ThomasG-29/2026_2C_PF_GenesysRoboticHand_Galindrez-Grassi/Conexionados/conexiones flex y servo.png

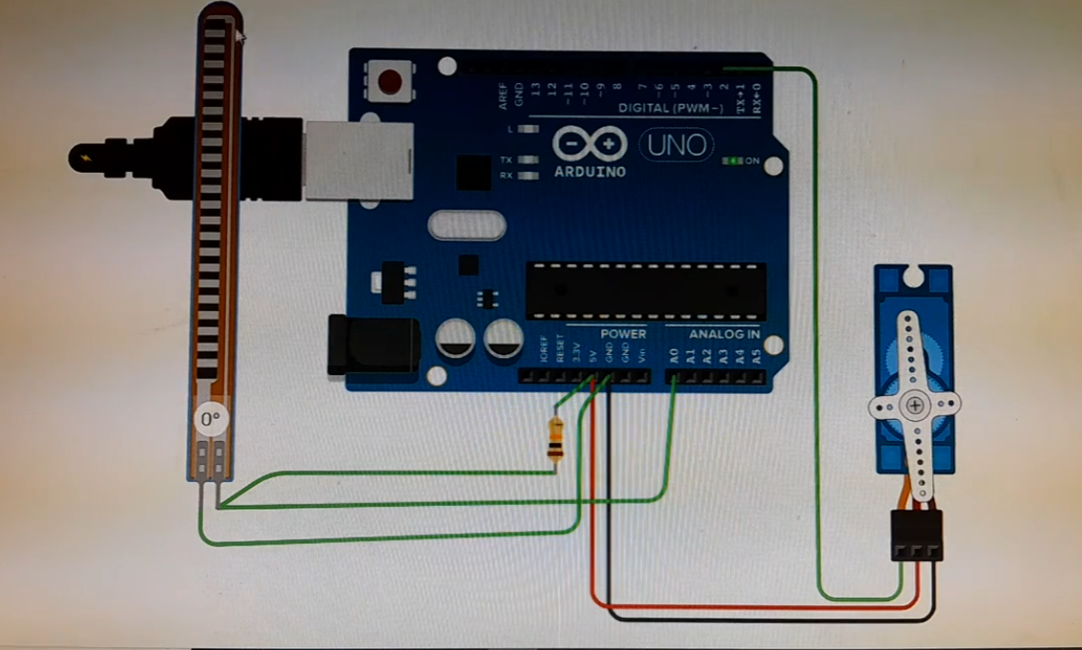
Conexionados/conexiones flex y servo.png
