ThomasG-29/2026_2C_PF_GenesysRoboticHand_Galindrez-Grassi/Documentación/Alcance y objetivos/Gantt Genesys.pdf

## Genesys - Gantt

Nombre | Personas asi… | Fecha límite | Prioridad

Proyectos

Mano humanoide robotica

Propuesta Final y Gantt | MG TG | Hace 3 días
Primera entrega con etapa parcial (por … | | 28/9/26
Segunda entrega incluyendo un porcen… | | 26/10/26
Entrega Proyecto con código fuente en … | | 16/11/26
Lista de materiales provisional | MG T | 16/8/26

Analisis de costos

Plazos de entregas de materiales

Analisis de costos

Plazos de entregas de materiales

Definición del mecanismo | TG | 4/10/26
Mecanismo de apertura y cierre de… | TG | martes
Determinar posición de los actuad… | MG TG | 24/8/26
Mecanismo de movimiento de pulgar | TG | martes
Definir mecanismo de muñeca, rev… | TG | 15/9/26
Definición del mecanismo de eslab… | | 20/9/26
Mecanismo de apertura y cierre de cad… | TG | martes
Impresión de las falanges y prueba… | | martes
Determinar la posición de los actua… | | 15/9/26
Determinar posición de actuadores… | | 15/9/26
Impresión y armado de los act… | | 27/9/26
Mecanismo de movimiento de pulgar | TG | martes
Definir mecanismo de muñeca, revisar … | TG | 15/9/26
Lista de materiales final | MG TG | 2/11/26
Armado de plaqueta con componentes … | MG | 13/9/26
Armado de componentes electrónicos p… | MG | 20/9/26
Pruebas funcionales integracion guante… | MG | 4/10/26
Pruebas funcionales del circuito de… | MG | 4/10/26
Pruebas funcionales del circuito de… | MG | 4/10/26
Calibración de sensores y servos | MG | 4/10/26
Pruebas de comunicación bluetooth/Wi… | MG | 11/10/26
Integración de baterías para el guante … | MG | 25/10/26
Integración componentes electrónicos … | MG TG | 18/10/26
Prueba funcional de la mano robot med… | MG TG | 15/11/26
Pruebas funcionales del circuito de sen… | MG | 4/10/26
Pruebas funcionales del circuito de la … | MG | 4/10/26
Calibración de sensores y servos | MG | 4/10/26
Definición del mecanismo de eslabones… | | 20/9/26
Impresión de las falanges y pruebas de… | | martes
Determinar la posición de los actuadore… | | 15/9/26
Determinar posición de actuadores de … | | 15/9/26
Impresión y armado de los actuado… | | 27/9/26
Impresión y armado de los actuadores … | | 27/9/26
ago. | 2026 | sep. | 2026 | oct. | 2026 | nov. | 2026
3-9 | W32 | 10-16 | W33 | 17-23 | W34 | 24-30 | W35 | 31-6 | W36 | 7-13 | W37 | 14-20 | W38 | 21-27 | W39 | 28-4 | W40 | 5-11 | W41 | 12-18 | W42 | 19-25 | W43 | 26-1 | W44 | 2-8 | W45 | 9-15 | W46 | 16-22 | W47 | 23-29 | W48
MGTG | Propuesta Final y Gantt

Primera entrega con etapa parcial (por ejemplo motores funcionando con driver y versión estable de SW). Con código fuente en Github

Segunda entrega incluyendo un porcentaje superior al 60% de las funcionalidades comprometidas. Con código fuente en Github

Entrega Proyecto con código fuente en Github de la materia

MG T Lista de materiales provisional

TG Definición del mecanismo

TG Mecanismo de apertura y cierre de cada falange

MGTG Determinar posición de los actuadores

TG Mecanismo de movimiento de pulgar

TG Definir mecanismo de muñeca, revisar efector de robots

Definición del mecanismo de eslabones para potenciómetros.

TG Mecanismo de apertura y cierre de cada falange

Impresión de las falanges y pruebas de movimientos

Determinar la posición de los actuadores de A/C

Determinar posición de actuadores de pulgar y mov. lateral

Impresión y armado de los actuadores en la V1 del antebrazo.

TG Mecanismo de movimiento de pulgar

TG Definir mecanismo de muñeca, revisar efector de robots

MGTG Lista de materiales final

MG Armado de plaqueta con componentes electronicos para el guante

MG Armado de componentes electrónicos para el brazo robot

MG Pruebas funcionales integracion guante y mecanismo

MG Pruebas funcionales del circuito de sensores del guante

MG Pruebas funcionales del circuito de la mano robot

MG Calibración de sensores y servos

MG Pruebas de comunicación bluetooth/WiFi entre microcontroladores

MG Integración de baterías para el guante y el prototipo robótico

MGTG Integración componentes electrónicos en el mecanismo

MG Pruebas funcionales del circuito de sensores del guante

MG Pruebas funcionales del circuito de la mano robot

MG Calibración de sensores y servos

Definición del mecanismo de eslabones para potenciómetros.

Impresión de las falanges y pruebas de movimientos

Determinar la posición de los actuadores de A/C

Determinar posición de actuadores de pulgar y mov. lateral

Impresión y armado de los actuadores en la V1 del antebrazo.

Impresión y armado de los actuadores en la V1 del antebrazo.
