ThomasG-29/2026_2C_PF_GenesysRoboticHand_Galindrez-Grassi/Conexionados/Circuito_guante - v2_bb.jpg

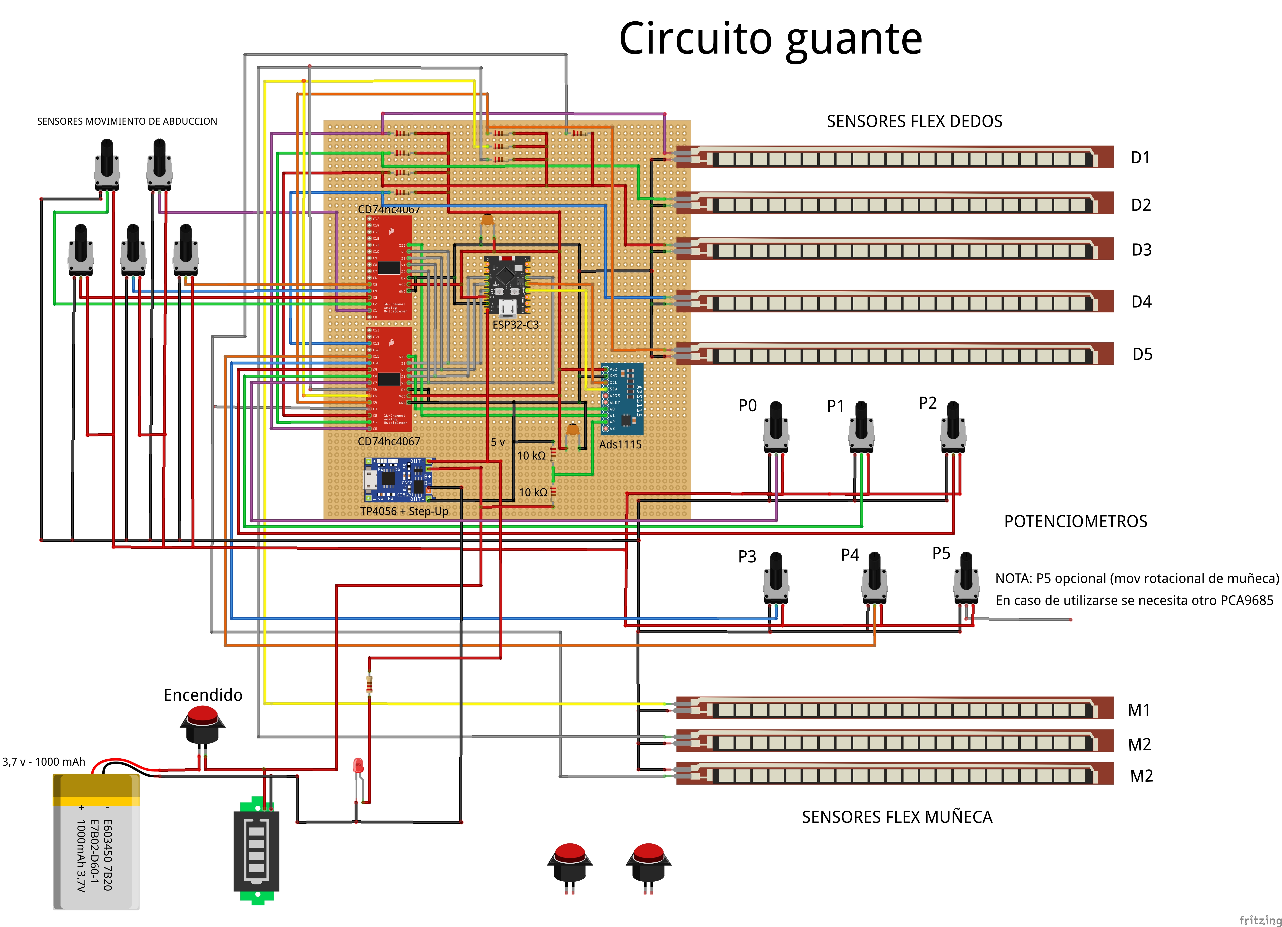
Conexionados/Circuito_guante - v2_bb.jpg
