ThomasG-29/2026_2C_PF_GenesysRoboticHand_Galindrez-Grassi/Conexionados/Circuito_guante_bb.png

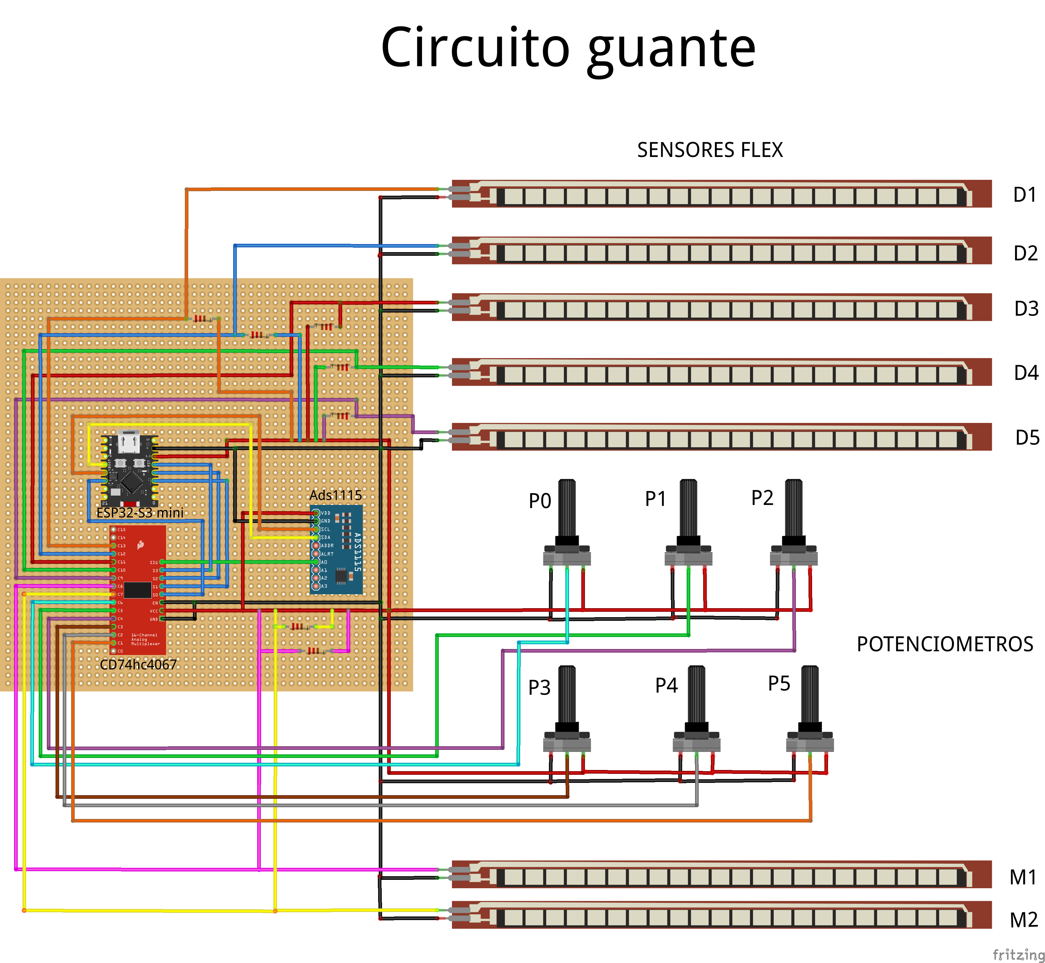
Conexionados/Circuito_guante_bb.png
