ThomasG-29/2026_2C_PF_GenesysRoboticHand_Galindrez-Grassi/Conexionados/Circuito_mano_robot_bb.jpg

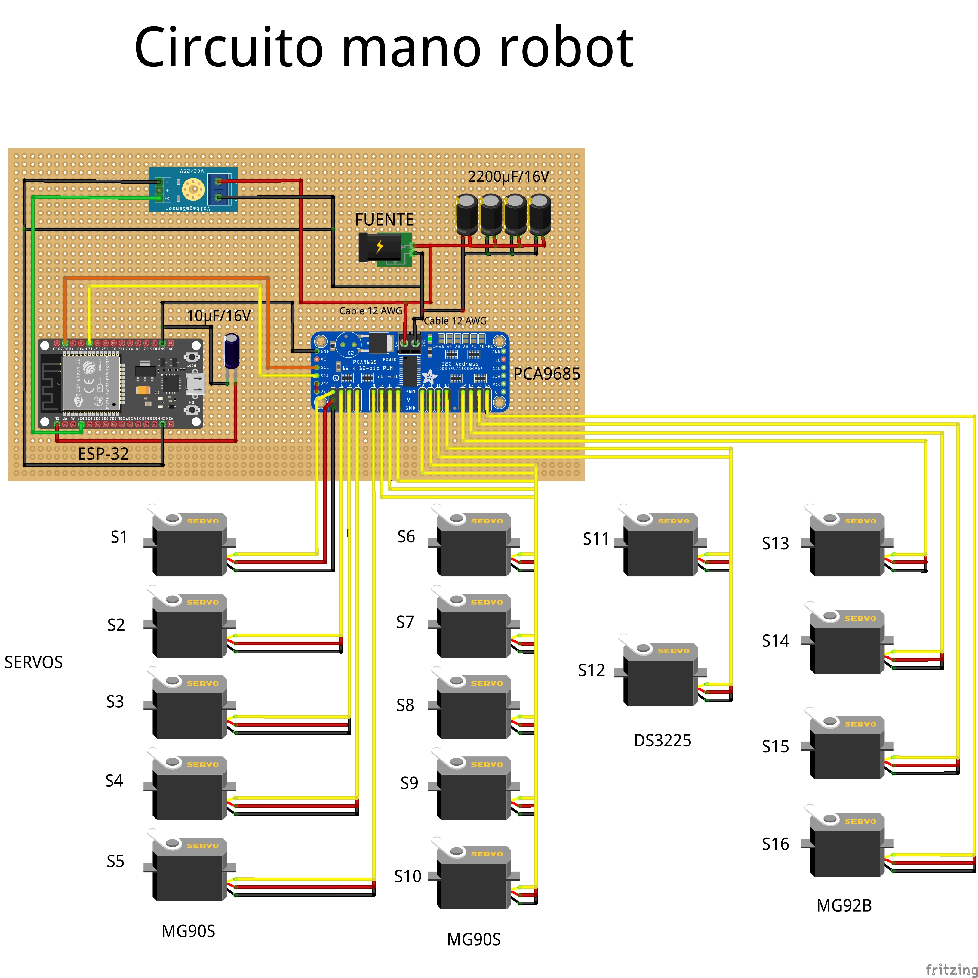
Conexionados/Circuito_mano_robot_bb.jpg
