ThomasG-29/2026_2C_PF_GenesysRoboticHand_Galindrez-Grassi/Documentación/Lista de materiales.xlsx

Sheet: Lista de materiales
LISTA DE MATERIALES
Item | Cantidad | Marca | modelo | Material | peso (gr) | Dimensiones (mm) | Precio unit(ARS) | Precio total | Total Dolares | Plazo de entrega (días) | Proveedor
Servomotor dedos | 10 | Towerpro | Mini Servo Mg90s | Plastico y metal | 16.5 | 31 x 11 x 31 | $8728.00 | $87280.00 | $58.19 | 2.00 | https://www.mercadolibre.com.ar/mini-servo-mg90s-18kg-torque-desarrollo-domotica/up/MLAU132173611
Servomotor muñeca y base (x2) | 1 | Generico | Dsservo Ds3225 | Plastico y metal | 67 | 40 x 20 x 40,5 | $58407.00 | $58407.00 | $38.94 | 15.00 | https://www.mercadolibre.com.ar/servo-digital-dsservo-ds3225-para-coche-25-kg-metal-gear-h/p/MLA2059431731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
Servomotor dedos abducción | 4 | Towerpro | Servo Mg92B | Plastico y metal | 13.8 | 22,8 x 12 x 31 | $22294.00 | $89176.00 | $59.45 | 4.00 | https://www.mercadolibre.com.ar/mini-servo-tower-pro-mg92b-metal-14gr-alto-torque-35kg/up/MLAU267010549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
Sensores flex (x 5) | 2 |  | Generico | ABS | 18 | 80 x 50 x 50 | $65958.00 | $131916.00 | $87.94 | 15.00 | https://www.mercadolibre.com.ar/sensor-de-flexion-5x-de-22-pulgadas-para-manipulador-electr/p/MLA2073926990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
Guante x2 | 1 | Generico | Generico | goma | 2 |  | $2000.00 | $2000.00 | $1.33 | Inmediato | Easy
Bobina De Hilo Multifilamento 8x Rojo 500 Mts | 1 | Colours | Generico | Nylon | 12 | 500 m | $40565.00 | $40565.00 | $27.04 | 2.00 | https://articulo.mercadolibre.com.ar/MLA-3337449752-bobina-de-hilo-multifilamento-8x-rojo-500-mts-035mm445kg-rojo-_JM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
Microcontrolador mano | 1 |  | ESP32 | PCB | 10 | 28 x 55 x 12 | $15990.00 | $15990.00 | $10.66 | 2.00 | https://www.mercadolibre.com.ar/nodemcu-esp32-38-pines-usb-c-wifi-bluetooth-placa-desarrollo-iot-compatible-arduino/p/MLA42485623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
Microcontrolador guante | 1 |  | ESP32-C3 SuperMini | PCB | 2 | 22,7 x 18 x 11 | $6929.00 | $6929.00 | $4.62 | 2.00 | https://www.mercadolibre.com.ar/nodemcu-esp32-c3-supermini-wifi-bluetooth-50-usb-c-iot-16-pines-compatible-arduino/p/MLA61634225
Controlador de servos | 1 |  | PCA9685 | PCB | 9 | 62,5 x 25,4 x 12 | $9900.00 | $9900.00 | $6.60 | 2.00 | https://www.mercadolibre.com.ar/controlador-servos-16-canales-i2c-pca9685-pwm-arduino-candy/up/MLAU270638199
Batería LiPo | 1 | Li-Poly | Generico | Litio | 16 | 43 x 25 x 9 | $16923.00 | $16923.00 | $11.28 | 2.00 | https://www.mercadolibre.com.ar/bateria-lipo-con-cable-jst-ph-37v-500mah/p/MLA2098680796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
Multiplexor 74hc4067 | 2 | OEM | CD74hc4067 | PCB | 2 | 18 x 41 | $6000.00 | $12000.00 | $8.00 | 2.00 | https://www.mercadolibre.com.ar/multiplexor-analogico-16-canales-74hc4067/up/MLAU397549426
Potenciometro Rv09 Horizontal Eje 6x12.5mm 10k Lineal | 10 | Elumiled | Rv09 | Metal | 5 | 12,5 x 9,7 | $4589.00 | $45890.00 | $30.59 | 2.00 | https://www.mercadolibre.com.ar/potenciometro-rv09-horizontal-eje-6x125mm-10k-lineal/up/MLAU3414529553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
Rollo de cables | 1 | Dupont | Varios | Cobre y pvc | 10 | 1 m de largo | $15890.00 | $15890.00 | $10.59 | 2.00 | https://articulo.mercadolibre.com.ar/MLA-1741277541-cable-plano-40-conductores-dupont-254mm-por-1-metro-_JM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
Tornillos y tuercas | 50 | Varios |  |  |  |  |  | $20000.00 | $13.33 | 2.00
Filamentos para estructura | 3 | Print a Lot/ Grilon / bambulab |  |  | 3000 |  | $30000.00 | $90000.00 | $60.00 | 2.00
Fuente alimentación 5v 20a 100w | 1 | Vapex | FM-5-20A | Metal | 500 | 60 x 180 x 200 | $33309.00 | $33309.00 | $22.21 | 2.00 | https://www.mercadolibre.com.ar/fuente-metalica-5v-20a-100w-vapex/p/MLA68261036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
Rodamientos MR106 zz | 45 |  | MR 106 |  | 45 | 6x10x3 | $2160.15 | $97206.75 | $64.80 | 2.00 | https://www.mercadolibre.com.ar/ruleman-mr-106-zz-6x10x3-x40-unidades-ms-rodamientos/up/MLAU258016962
Cargador Bateria Litio Tp4056 | 1 | INFORMATICA SAN ISIDRO | Tp4056 | PCB | 1 | 10 x 23,5 x 33 | $4990.00 | $4990.00 | $3.33 | 2.00 | https://www.mercadolibre.com.ar/cargador-bateria-litio-tp4056-1a-con-fuente-boost-step-up-2a/up/MLAU2907940508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
Modulo Indicador Carga De Bateria De Litio | 1 | Candy-Ho | Generico | Plastico | 1 | 45 x 20 x 8 | $7086.00 | $7086.00 | $4.72 | 2.00 | https://www.mercadolibre.com.ar/modulo-indicador-carga-de-bateria-de-litio-3s-111v--126v/up/MLAU309927320
Capacitor cerámico | 3 |  | Generico | ceramico | 1 |  | $300.00 | $900.00 | $0.60 | inmediato | Full electronica
Capacitor electrolitico x20 | 1 | Candy-Ho | Generico |  | 1 | 0,2 x 0,13 | $12134.00 | $12134.00 | $8.09 | 2.00 | https://www.mercadolibre.com.ar/pack-x20-capacitor-electrolitico-2200uf-16v-low-esr-10x20mm/up/MLAU4564573641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
Diodo Schottky | 1 |  | Generico |  | 1 |  | $300.00 | $300.00 | $0.20 | inmediato | Full electronica
Placa experimental | 1 | ELEPRINT | PE-44 | PCB | 5 | 15 x 10 | $12400.00 | $12400.00 | $8.27 | 2.00 | Full electronica
Resistencias x50 | 1 |  |  |  |  |  | $3990.00 | $3990.00 | $2.66 | 2.00 | https://articulo.mercadolibre.com.ar/MLA-1484686813-pack-50-resistencias-1-14w-metal-film-1-a-91-kohm-elegir-_JM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
Conversor Ads1115 | 1 | Generico | Ads1115 | PCB | 5 | 30 x 18 x 3 | $7999.00 | $7999.00 | $5.33 | 2.00 | https://www.mercadolibre.com.ar/ads1115-adc-16-bit-conversor-ad-4-canales-arduino/p/MLA2038776439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
Modulo Sensor De Tension | 1 | INFORMATICA SAN ISIDRO | Modulo Sensor de Tension Voltaje 0v-25v Dc Arduino | PCB | 2 | 20 x 10 x 10 | $3789.00 | $3789.00 | $2.53 | 2.00 | https://www.mercadolibre.com.ar/modulo-sensor-de-tension-voltaje-0v25v-dc-arduino/up/MLAU292830096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
Pack X3 Boton Pulsador Switch Sin Retencion | 1 | INFORMATICA SAN ISIDRO | Generico | plastico | 3 | 10 x 25,5 | $7215.00 | $7215.00 | $4.81 | 2.00 | https://www.mercadolibre.com.ar/pack-x3-boton-pulsador-switch-sin-retencion-2-pines-10mm/up/MLAU3597061591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
Pack X3 Boton Pulsador Switch Retencion | 1 | INFORMATICA SAN ISIDRO | Generico | plastico | 3 | 13 x 19,5 | $8763.00 | $8763.00 | $5.84 | 2.00 | https://www.mercadolibre.com.ar/pack-x3-boton-pulsador-switch-retencion-selflock-10mm-rojo/up/MLAU3644919741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
Leds genericos | 1 | Generico | Generico | plastico | 1 | 8 x 30 x 5 | $9364.00 | $9364.00 | $6.24 | 1.00 | https://www.mercadolibre.com.ar/pack-30-leds-5mm-rojo-amarillo-verde-arduino-nubbeo-variados/p/MLA78714347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|item_id:MLA3896689262#is_advertising=true&searchVariation=MLA78714347&backend_model=search-backend&be_origin=searchv2&position=4&search_layout=grid&type=pad&tracking_id=93dc18bf-5e5c-4c39-8b38-4017776e893c&ad_domain=VQCATCORE_LST&ad_position=4&ad_click_id=OGVmNTNlMmUtMWIzZS00ODg2LTlkMjYtYTdhMzIyNzc2YjYw
Total |  |  |  |  | 3752.3 |  |  | $852311.75 | $568.21 |  | 27

Sheet: Herramientas
Herramientas
Impresora 3D
Soldador
Multímetro
Destornillador
Cinta aisladora
Fuente alimentacion
Pinza
Alicate
Pegamento
