ThomasG-29/2026_2C_PF_GenesysRoboticHand_Galindrez-Grassi/Documentación/Diagrama_Gantt-Mano_humanoide_robotica.xlsx

Sheet: Gantt
Proyecto Genesys - Mano humanoide robótica
Diagrama de Gantt · Proyecto final de Ingeniería Mecatrónica |  |  |  | Inicio del proyecto | 2026-08-10
Equipo: Mayra Grassi (M) · Thomas Agustín Galindrez (T) |  |  |  | Desplazar vista (días) | 0
53 tareas y subtareas | 35 completadas |  | 11 en curso |  | 7 pendientes |  | 174 h registradas |  | 2026-08-10 |  |  |  |  |  |  | 2026-08-17 |  |  |  |  |  |  | 2026-08-24 |  |  |  |  |  |  | 2026-08-31 |  |  |  |  |  |  | 2026-09-07 |  |  |  |  |  |  | 2026-09-14 |  |  |  |  |  |  | 2026-09-21 |  |  |  |  |  |  | 2026-09-28
 |  |  |  |  |  |  |  |  | 2026-08-10 | 2026-08-11 | 2026-08-12 | 2026-08-13 | 2026-08-14 | 2026-08-15 | 2026-08-16 | 2026-08-17 | 2026-08-18 | 2026-08-19 | 2026-08-20 | 2026-08-21 | 2026-08-22 | 2026-08-23 | 2026-08-24 | 2026-08-25 | 2026-08-26 | 2026-08-27 | 2026-08-28 | 2026-08-29 | 2026-08-30 | 2026-08-31 | 2026-09-01 | 2026-09-02 | 2026-09-03 | 2026-09-04 | 2026-09-05 | 2026-09-06 | 2026-09-07 | 2026-09-08 | 2026-09-09 | 2026-09-10 | 2026-09-11 | 2026-09-12 | 2026-09-13 | 2026-09-14 | 2026-09-15 | 2026-09-16 | 2026-09-17 | 2026-09-18 | 2026-09-19 | 2026-09-20 | 2026-09-21 | 2026-09-22 | 2026-09-23 | 2026-09-24 | 2026-09-25 | 2026-09-26 | 2026-09-27 | 2026-09-28
Tarea | Resp. | Estado | Progreso | Inicio | Fin | Horas est. | Horas reales | Observaciones | L | M | X | J | V | S | D | L | M | X | J | V | S | D | L | M | X | J | V | S | D | L | M | X | J | V | S | D | L | M | X | J | V | S | D | L | M | X | J | V | S | D | L | M | X | J | V | S | D | L
GESTIÓN, DOCUMENTACIÓN Y ENTREGAS
Lista de materiales provisional | M/T | ● Completada | 100% | 2026-08-11 | 2026-08-16 |  | 1.0 | Cerrada el 08/09 · asignada a usuario fuera del espacio
Analisis de costos | — | ● Completada | 100% | 2026-08-11 | 2026-09-08 |  |  | Cerrada el 08/09 · fechas = creación/cierre · sin responsable
Plazos de entregas de materiales | — | ● Completada | 100% | 2026-08-11 | 2026-09-08 |  |  | Cerrada el 08/09 · fechas = creación/cierre · sin responsable
Propuesta Inicial | M/T | ● Completada | 100% | 2026-08-13 | 2026-08-24 |  |  | Cerrada el 25/08 · inicio = 1.ª subtarea
Definición del alcance | M/T | ● Completada | 100% | 2026-08-13 | 2026-08-13 |  |  | Cerrada el 25/08 · sin inicio en ClickUp
Creación de Github y publicación de la primera versión con el alcance preeliminar | T | ● Completada | 100% | 2026-08-24 | 2026-08-24 |  | 1.5 | Cerrada el 25/08 · sin inicio en ClickUp
Propuesta Final y Gantt | M/T | ● Completada | 100% | 2026-09-03 | 2026-09-03 |  |  | Cerrada el 08/09 · sin inicio en ClickUp
Primera entrega con etapa parcial (por ejemplo motores funcionando con driver y versión estable de SW). Con código fuente en Github | M/T | ● Completada | 100% | 2026-09-28 | 2026-09-28 |  |  | Cerrada el 29/09 · sin inicio en ClickUp
Segunda entrega incluyendo un porcentaje superior al 60% de las funcionalidades comprometidas. Con código fuente en Github | M/T | ● Completada | 100% | 2026-10-26 | 2026-10-26 |  |  | Cerrada el 09/11 · sin inicio en ClickUp
Lista de materiales final | M/T | ● Completada | 100% | 2026-11-02 | 2026-11-02 |  | 2.6 | Cerrada el 06/10 · sin inicio en ClickUp
Entrega Proyecto con código fuente en Github de la materia | M/T | ● Pendiente | 0% | 2026-11-16 | 2026-11-16 |  |  | Sin inicio en ClickUp
DISEÑO MECÁNICO
Escaneo mano de colo | Otro | ● Completada | 100% | 2026-08-11 | 2026-08-15 |  | 2.0 | Cerrada el 18/08 · asignada a usuario fuera del espacio
Definición del mecanismo | T | ● En curso | 40% | 2026-08-13 | 2026-10-04 |  | 28.1
Mecanismo de apertura y cierre de cada falange | T | ● En curso | 0% | 2026-08-13 | 2026-09-08 |  | 31.5
Impresión de las falanges y pruebas de movimientos | — | ● Pendiente | 0% | 2026-08-31 | 2026-09-08 |  |  | Sin responsable
Determinar la posición de los actuadores de A/C | — | ● Pendiente | 0% | 2026-08-31 | 2026-09-15 |  |  | Sin responsable
Determinar posición de actuadores de pulgar y mov. lateral | — | ● Pendiente | 0% | 2026-08-31 | 2026-09-15 |  |  | Sin responsable
Impresión y armado de los actuadores en la V1 del antebrazo. | — | ● Pendiente | 0% | 2026-09-14 | 2026-09-27 |  |  | Sin responsable
Determinar posición de los actuadores | M/T | ● Completada | 100% | 2026-08-24 | 2026-08-24 |  | 2.0 | Cerrada el 25/08 · sin inicio en ClickUp
Definir mecanismo de muñeca, revisar efector de robots | T | ● En curso | 50% | 2026-08-31 | 2026-09-15
Mecanismo de movimiento de pulgar | T | ● En curso | 50% | 2026-09-08 | 2026-09-08 |  |  | Sin inicio en ClickUp
Definición del mecanismo de eslabones para potenciómetros. | — | ● Pendiente | 0% | 2026-09-20 | 2026-09-20 |  |  | Sin inicio en ClickUp · sin responsable
Preparaciones - Calibraciones de impresoras 3D y maquinas de fabricación. | T | ● En curso | 50% | 2026-10-12 |  |  | 3.5 | Inicio = creación · sin fecha de fin
DESARROLLO ELECTRÓNICO Y GUANTE
Pruebas de electrónica | M | ● Completada | 100% | 2026-08-26 | 2026-08-27 |  |  | Cerrada el 26/08 · inicio = 1.ª subtarea · fin = última subtarea
Controlar servomotores mediante código. | M | ● Completada | 100% | 2026-08-26 | 2026-08-26 |  | 0.6 | Cerrada el 26/08 · sin inicio en ClickUp
Leer los valores analógicos de los sensores flex | M | ● Completada | 100% | 2026-08-26 | 2026-08-26 |  | 0.6 | Cerrada el 26/08 · sin inicio en ClickUp
Controlar servomotores mediante flex posicionados en un guante y calibrar movimientos | M | ● Completada | 100% | 2026-08-27 | 2026-08-27 |  | 0.7 | Cerrada el 26/08 · sin inicio en ClickUp
Determinación sensores extras para GDL de muñeca | M | ● Completada | 100% | 2026-08-28 | 2026-08-29 |  | 1.0 | Cerrada el 30/08
Armado de diagramas de conexionados | M | ● Completada | 100% | 2026-08-29 | 2026-09-20 |  | 7.4 | Cerrada el 12/10
Armado de plaqueta con componentes electronicos para el guante | M | ● Completada | 100% | 2026-08-31 | 2026-09-13 |  |  | Cerrada el 06/10
Armado y pruebas en protoboard | M | ● Completada | 100% | 2026-08-31 | 2026-09-06 |  | 8.3 | Cerrada el 08/09
Armado de componentes en plaqueta | M | ● Completada | 100% | 2026-09-06 | 2026-09-11 |  | 1.2 | Cerrada el 09/09
Soldadura en plaqueta PCB | M | ● Completada | 100% | 2026-09-06 | 2026-09-11 |  | 21.3 | Cerrada el 06/10
Pruebas con componentes soldados en la PCB | M | ● Completada | 100% | 2026-09-11 | 2026-09-13 |  | 5.4 | Cerrada el 06/10
Armado de componentes electrónicos para el brazo robot | M | ● Completada | 100% | 2026-09-14 | 2026-09-20 |  | 0.5 | Cerrada el 27/09
Armado y pruebas en protoboard | M | ● Completada | 100% | 2026-09-14 | 2026-09-18 |  | 3.5 | Cerrada el 27/09
Soldado de componentes | M | ● Completada | 100% | 2026-09-14 | 2026-09-18 |  | 2.3 | Cerrada el 12/10
Pruebas funcionales | M | ● Completada | 100% | 2026-09-18 | 2026-09-20 |  | 3.0 | Cerrada el 27/09
Diseño del guante: implementación de sensores, cables y accesorios | M | ● En curso | 83.33333333% | 2026-10-12 | 2026-10-25 | 20.0 | 13.4
Pruebas funcionales y ajuste de sensores | M | ● Completada | 100% | 2026-10-12 | 2026-10-18 |  | 1.9 | Cerrada el 25/10
Implementación de mecanismo para potenciometros | M | ● Completada | 100% | 2026-10-19 | 2026-10-25 |  | 4.7 | Cerrada el 24/10
Carcasa para el guante | M | ● En curso | 50% | 2026-10-27 | 2026-11-01 |  | 6.5
Integración de baterías para el guante | M | ● Completada | 100% | 2026-11-09 | 2026-11-15 |  | 4.3 | Cerrada el 09/11
INTEGRACIÓN Y PRUEBAS
Pruebas funcionales inalambricas - integración guante y mecanismo | M | ● Completada | 100% | 2026-09-21 | 2026-10-11 |  |  | Cerrada el 12/10
Pruebas de comunicación bluetooth/WiFi/ESP-NOW entre microcontroladores | M | ● Completada | 100% | 2026-09-21 | 2026-09-24 |  | 9.7 | Cerrada el 12/10
Pruebas funcionales de comunicación entre los sensores y servos | M | ● Completada | 100% | 2026-09-25 | 2026-09-30 |  | 1.2 | Cerrada el 12/10
Calibración de sensores y servos | M | ● Completada | 100% | 2026-10-01 | 2026-10-04 |  | 0.8 | Cerrada el 12/10
Seteo de servomotores en cero | M | ● Completada | 100% | 2026-10-12 | 2026-10-12 |  | 0.6 | Cerrada el 12/10 · fechas = creación/cierre
Integración componentes electrónicos en el mecanismo | M/T | ● En curso | 50% | 2026-10-19 | 2026-10-25 |  | 1.7
Prueba funcional de la mano robot mediante el guante | M/T | ● En curso | 33.33333333% | 2026-10-26 | 2026-11-15 |  | 0.7
Agregado de condiciones de seguridad, home y demás | M | ● En curso | 50% | 2026-10-26 | 2026-11-15 | 1.0 | 0.4
Ajustes mecánicos, electrónicos y físicos | M/T | ● Pendiente | 0% | 2026-10-26 | 2026-11-15
Calibracion de sensores con la mano | M/T | ● En curso | 50% | 2026-10-26 | 2026-11-15 | 3.0
Fechas importantes
Propuesta inicial | 2026-08-24 |  | ● Completada
Propuesta final y Gantt | 2026-09-03 |  | ● Completada
Primera entrega: etapa parcial (motores con driver y versión estable de SW) + código en GitHub | 2026-09-28 |  | ● Completada
Segunda entrega: más del 60% de las funcionalidades comprometidas + código en GitHub | 2026-10-26 |  | ● Completada
Entrega final del proyecto con código fuente en GitHub | 2026-11-16 |  | ● Pendiente
Resumen de horas
Horas estimadas (ClickUp) | 24.0 h
Horas reales (tiempo registrado + carga manual) | 173.9 h
Referencias
Duración planificada (inicio → fin)
Parte completada según el % de progreso
Día de hoy
Valores editables o cargados a mano (azul) | 123
Progreso de tareas con subtareas = promedio de sus subtareas
Horas reales = tiempo registrado en esa tarea, sin sumar subtareas; verde si no supera lo estimado, rojo si lo supera
Fuente: ClickUp, espacio «Mano humanoide robótica». Datos exportados el 10/11/2026 (incluye 160 registros de tiempo).

Sheet: Datos ClickUp
ID | Tarea | Tarea padre | Nivel | Estado | Responsables | Inicio (ClickUp) | Vencimiento (ClickUp) | Creada | Cerrada | Estimado (h) | Tiempo registrado (h) | Link
86e2ry5t9 | Lista de materiales provisional |  | 0 | ● Completada | Usuario fuera del espacio (101307576), Mayra Grassi | 2026-08-11 | 2026-08-16 | 2026-08-11 | 2026-09-08 |  | 1.00 | https://app.clickup.com/t/86e2ry5t9
86e2ry5yx | Analisis de costos | Lista de materiales provisional | 1 | ● Completada |  |  |  | 2026-08-11 | 2026-09-08 |  |  | https://app.clickup.com/t/86e2ry5yx
86e2ry61p | Plazos de entregas de materiales | Lista de materiales provisional | 1 | ● Completada |  |  |  | 2026-08-11 | 2026-09-08 |  |  | https://app.clickup.com/t/86e2ry61p
86e2rwcjk | Propuesta Inicial |  | 0 | ● Completada | Mayra Grassi, Thomas Agustín Galindrez |  | 2026-08-24 | 2026-08-11 | 2026-08-25 |  |  | https://app.clickup.com/t/86e2rwcjk
86e2u4cyx | Definición del alcance | Propuesta Inicial | 1 | ● Completada | Mayra Grassi, Thomas Agustín Galindrez |  | 2026-08-13 | 2026-08-13 | 2026-08-25 |  |  | https://app.clickup.com/t/86e2u4cyx
86e2z32pw | Creación de Github y publicación de la primera versión con el alcance preeliminar |  | 0 | ● Completada | Thomas Agustín Galindrez |  | 2026-08-24 | 2026-08-25 | 2026-08-25 |  | 1.50 | https://app.clickup.com/t/86e2z32pw
86e2rwdj1 | Propuesta Final y Gantt |  | 0 | ● Completada | Mayra Grassi, Thomas Agustín Galindrez |  | 2026-09-03 | 2026-08-11 | 2026-09-08 |  |  | https://app.clickup.com/t/86e2rwdj1
86e2rwe16 | Primera entrega con etapa parcial (por ejemplo motores funcionando con driver y versión estable de SW). Con código fuente en Github |  | 0 | ● Completada | Mayra Grassi, Thomas Agustín Galindrez |  | 2026-09-28 | 2026-08-11 | 2026-09-29 |  |  | https://app.clickup.com/t/86e2rwe16
86e2rwe88 | Segunda entrega incluyendo un porcentaje superior al 60% de las funcionalidades comprometidas. Con código fuente en Github |  | 0 | ● Completada | Mayra Grassi, Thomas Agustín Galindrez |  | 2026-10-26 | 2026-08-11 | 2026-11-09 |  |  | https://app.clickup.com/t/86e2rwe88
86e31y25r | Lista de materiales final |  | 0 | ● Completada | Mayra Grassi, Thomas Agustín Galindrez |  | 2026-11-02 | 2026-08-31 | 2026-10-06 |  | 2.62 | https://app.clickup.com/t/86e31y25r
86e2rwebj | Entrega Proyecto con código fuente en Github de la materia |  | 0 | ● Pendiente | Mayra Grassi, Thomas Agustín Galindrez |  | 2026-11-16 | 2026-08-11 |  |  |  | https://app.clickup.com/t/86e2rwebj
86e2ry5cd | Escaneo mano de colo |  | 0 | ● Completada | Usuario fuera del espacio (101307576) | 2026-08-11 | 2026-08-15 | 2026-08-11 | 2026-08-18 |  | 2.00 | https://app.clickup.com/t/86e2ry5cd
86e2u49jz | Definición del mecanismo |  | 0 | ● En curso | Thomas Agustín Galindrez | 2026-08-13 | 2026-10-04 | 2026-08-13 |  |  | 28.08 | https://app.clickup.com/t/86e2u49jz
86e2u49qp | Mecanismo de apertura y cierre de cada falange | Definición del mecanismo | 1 | ● En curso | Thomas Agustín Galindrez | 2026-08-13 | 2026-09-08 | 2026-08-13 |  |  | 31.51 | https://app.clickup.com/t/86e2u49qp
86e31yzjv | Impresión de las falanges y pruebas de movimientos | Mecanismo de apertura y cierre de cada falange | 2 | ● Pendiente |  | 2026-08-31 | 2026-09-08 | 2026-08-31 |  |  |  | https://app.clickup.com/t/86e31yzjv
86e31z08g | Determinar la posición de los actuadores de A/C | Mecanismo de apertura y cierre de cada falange | 2 | ● Pendiente |  | 2026-08-31 | 2026-09-15 | 2026-08-31 |  |  |  | https://app.clickup.com/t/86e31z08g
86e31z0me | Determinar posición de actuadores de pulgar y mov. lateral | Mecanismo de apertura y cierre de cada falange | 2 | ● Pendiente |  | 2026-08-31 | 2026-09-15 | 2026-08-31 |  |  |  | https://app.clickup.com/t/86e31z0me
86e31z138 | Impresión y armado de los actuadores en la V1 del antebrazo. | Determinar posición de actuadores de pulgar y mov. lateral | 3 | ● Pendiente |  | 2026-09-14 | 2026-09-27 | 2026-08-31 |  |  |  | https://app.clickup.com/t/86e31z138
86e2u49tv | Determinar posición de los actuadores | Definición del mecanismo | 1 | ● Completada | Mayra Grassi, Thomas Agustín Galindrez |  | 2026-08-24 | 2026-08-13 | 2026-08-25 |  | 2.00 | https://app.clickup.com/t/86e2u49tv
86e2w8jwz | Definir mecanismo de muñeca, revisar efector de robots | Definición del mecanismo | 1 | ● En curso | Thomas Agustín Galindrez | 2026-08-31 | 2026-09-15 | 2026-08-18 |  |  |  | https://app.clickup.com/t/86e2w8jwz
86e2u4a20 | Mecanismo de movimiento de pulgar | Definición del mecanismo | 1 | ● En curso | Thomas Agustín Galindrez |  | 2026-09-08 | 2026-08-13 |  |  |  | https://app.clickup.com/t/86e2u4a20
86e31ytyg | Definición del mecanismo de eslabones para potenciómetros. | Definición del mecanismo | 1 | ● Pendiente |  |  | 2026-09-20 | 2026-08-31 |  |  |  | https://app.clickup.com/t/86e31ytyg
86e3pbbqa | Preparaciones - Calibraciones de impresoras 3D y maquinas de fabricación. |  | 0 | ● En curso | Thomas Agustín Galindrez |  |  | 2026-10-12 |  |  | 3.55 | https://app.clickup.com/t/86e3pbbqa
86e2z33yd | Pruebas de electrónica |  | 0 | ● Completada | Mayra Grassi |  |  | 2026-08-25 | 2026-08-26 |  |  | https://app.clickup.com/t/86e2z33yd
86e2z348f | Controlar servomotores mediante código. | Pruebas de electrónica | 1 | ● Completada | Mayra Grassi |  | 2026-08-26 | 2026-08-25 | 2026-08-26 |  | 0.63 | https://app.clickup.com/t/86e2z348f
86e2z346y | Leer los valores analógicos de los sensores flex | Pruebas de electrónica | 1 | ● Completada | Mayra Grassi |  | 2026-08-26 | 2026-08-25 | 2026-08-26 |  | 0.58 | https://app.clickup.com/t/86e2z346y
86e2z365a | Controlar servomotores mediante flex posicionados en un guante y calibrar movimientos | Pruebas de electrónica | 1 | ● Completada | Mayra Grassi |  | 2026-08-27 | 2026-08-25 | 2026-08-26 |  | 0.67 | https://app.clickup.com/t/86e2z365a
86e2z376z | Determinación sensores extras para GDL de muñeca |  | 0 | ● Completada | Mayra Grassi | 2026-08-28 | 2026-08-29 | 2026-08-25 | 2026-08-30 |  | 1.03 | https://app.clickup.com/t/86e2z376z
86e31bqq6 | Armado de diagramas de conexionados |  | 0 | ● Completada | Mayra Grassi | 2026-08-29 | 2026-09-20 | 2026-08-30 | 2026-10-12 |  | 7.43 | https://app.clickup.com/t/86e31bqq6
86e31y3wa | Armado de plaqueta con componentes electronicos para el guante |  | 0 | ● Completada | Mayra Grassi | 2026-08-31 | 2026-09-13 | 2026-08-31 | 2026-10-06 |  |  | https://app.clickup.com/t/86e31y3wa
86e360p6r | Armado y pruebas en protoboard | Armado de plaqueta con componentes electronicos para el guante | 1 | ● Completada | Mayra Grassi | 2026-08-31 | 2026-09-06 | 2026-09-08 | 2026-09-08 |  | 8.33 | https://app.clickup.com/t/86e360p6r
86e36u63r | Armado de componentes en plaqueta | Armado de plaqueta con componentes electronicos para el guante | 1 | ● Completada | Mayra Grassi | 2026-09-06 | 2026-09-11 | 2026-09-09 | 2026-09-09 |  | 1.20 | https://app.clickup.com/t/86e36u63r
86e360pec | Soldadura en plaqueta PCB | Armado de plaqueta con componentes electronicos para el guante | 1 | ● Completada | Mayra Grassi | 2026-09-06 | 2026-09-11 | 2026-09-08 | 2026-10-06 |  | 21.28 | https://app.clickup.com/t/86e360pec
86e360put | Pruebas con componentes soldados en la PCB | Armado de plaqueta con componentes electronicos para el guante | 1 | ● Completada | Mayra Grassi | 2026-09-11 | 2026-09-13 | 2026-09-08 | 2026-10-06 |  | 5.36 | https://app.clickup.com/t/86e360put
86e31y4ee | Armado de componentes electrónicos para el brazo robot |  | 0 | ● Completada | Mayra Grassi | 2026-09-14 | 2026-09-20 | 2026-08-31 | 2026-09-27 |  | 0.45 | https://app.clickup.com/t/86e31y4ee
86e360ryp | Armado y pruebas en protoboard | Armado de componentes electrónicos para el brazo robot | 1 | ● Completada | Mayra Grassi | 2026-09-14 | 2026-09-18 | 2026-09-08 | 2026-09-27 |  | 3.47 | https://app.clickup.com/t/86e360ryp
86e3pcd2v | Soldado de componentes | Armado de componentes electrónicos para el brazo robot | 1 | ● Completada | Mayra Grassi | 2026-09-14 | 2026-09-18 | 2026-10-12 | 2026-10-12 |  | 2.32 | https://app.clickup.com/t/86e3pcd2v
86e360tnn | Pruebas funcionales | Armado de componentes electrónicos para el brazo robot | 1 | ● Completada | Mayra Grassi | 2026-09-18 | 2026-09-20 | 2026-09-08 | 2026-09-27 |  | 3.00 | https://app.clickup.com/t/86e360tnn
86e38dytm | Diseño del guante: implementación de sensores, cables y accesorios |  | 0 | ● En curso | Mayra Grassi | 2026-10-12 | 2026-10-25 | 2026-09-13 |  | 20.00 | 13.42 | https://app.clickup.com/t/86e38dytm
86e3rvrnz | Pruebas funcionales y ajuste de sensores | Diseño del guante: implementación de sensores, cables y accesorios | 1 | ● Completada | Mayra Grassi | 2026-10-12 | 2026-10-18 | 2026-10-17 | 2026-10-25 |  | 1.95 | https://app.clickup.com/t/86e3rvrnz
1dfe8wf21xp | Implementación de mecanismo para potenciometros | Diseño del guante: implementación de sensores, cables y accesorios | 1 | ● Completada | Mayra Grassi | 2026-10-19 | 2026-10-25 | 2026-10-21 | 2026-10-24 |  | 4.72 | https://app.clickup.com/t/1dfe8wf21xp
1dfe8wf2e9b | Carcasa para el guante | Diseño del guante: implementación de sensores, cables y accesorios | 1 | ● En curso | Mayra Grassi | 2026-10-27 | 2026-11-01 | 2026-10-27 |  |  |  | https://app.clickup.com/t/1dfe8wf2e9b
86e31yaq0 | Integración de baterías para el guante |  | 0 | ● Completada | Mayra Grassi | 2026-11-09 | 2026-11-15 | 2026-08-31 | 2026-11-09 |  | 4.28 | https://app.clickup.com/t/86e31yaq0
86e31y5e3 | Pruebas funcionales inalambricas - integración guante y mecanismo |  | 0 | ● Completada | Mayra Grassi | 2026-09-21 | 2026-10-11 | 2026-08-31 | 2026-10-12 |  |  | https://app.clickup.com/t/86e31y5e3
86e38dx4y | Pruebas de comunicación bluetooth/WiFi/ESP-NOW entre microcontroladores | Pruebas funcionales inalambricas - integración guante y mecanismo | 1 | ● Completada | Mayra Grassi | 2026-09-21 | 2026-09-24 | 2026-09-13 | 2026-10-12 |  | 9.71 | https://app.clickup.com/t/86e38dx4y
86e31yfbj | Pruebas funcionales de comunicación entre los sensores y servos | Pruebas funcionales inalambricas - integración guante y mecanismo | 1 | ● Completada | Mayra Grassi | 2026-09-25 | 2026-09-30 | 2026-08-31 | 2026-10-12 |  | 1.19 | https://app.clickup.com/t/86e31yfbj
86e31yerb | Calibración de sensores y servos | Pruebas funcionales inalambricas - integración guante y mecanismo | 1 | ● Completada | Mayra Grassi | 2026-10-01 | 2026-10-04 | 2026-08-31 | 2026-10-12 |  | 0.78 | https://app.clickup.com/t/86e31yerb
86e3p83u9 | Seteo de servomotores en cero | Calibración de sensores y servos | 2 | ● Completada | Mayra Grassi |  |  | 2026-10-12 | 2026-10-12 |  | 0.63 | https://app.clickup.com/t/86e3p83u9
86e31ybxg | Integración componentes electrónicos en el mecanismo |  | 0 | ● En curso | Mayra Grassi, Thomas Agustín Galindrez | 2026-10-19 | 2026-10-25 | 2026-08-31 |  |  | 1.72 | https://app.clickup.com/t/86e31ybxg
86e31yc41 | Prueba funcional de la mano robot mediante el guante |  | 0 | ● En curso | Mayra Grassi, Thomas Agustín Galindrez | 2026-10-26 | 2026-11-15 | 2026-08-31 |  |  | 0.67 | https://app.clickup.com/t/86e31yc41
86e3rw72e | Agregado de condiciones de seguridad, home y demás | Prueba funcional de la mano robot mediante el guante | 1 | ● En curso | Mayra Grassi | 2026-10-26 | 2026-11-15 | 2026-10-17 |  | 1.00 | 0.37 | https://app.clickup.com/t/86e3rw72e
86e3rw7eb | Ajustes mecánicos, electrónicos y físicos | Prueba funcional de la mano robot mediante el guante | 1 | ● Pendiente | Mayra Grassi, Thomas Agustín Galindrez | 2026-10-26 | 2026-11-15 | 2026-10-17 |  |  |  | https://app.clickup.com/t/86e3rw7eb
86e3rw6wx | Calibracion de sensores con la mano | Prueba funcional de la mano robot mediante el guante | 1 | ● En curso | Mayra Grassi, Thomas Agustín Galindrez | 2026-10-26 | 2026-11-15 | 2026-10-17 |  | 3.00 |  | https://app.clickup.com/t/86e3rw6wx
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
