ThomasG-29/2026_2C_PF_GenesysRoboticHand_Galindrez-Grassi/Documentación/Medidas componentes/Boton_retencion.png

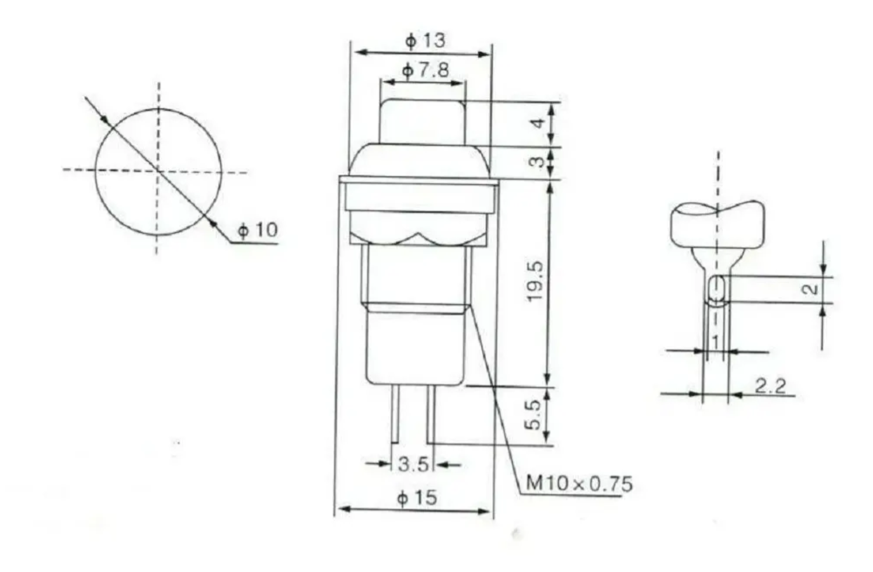
Documentación/Medidas componentes/Boton_retencion.png
