ThomasG-29/2026_2C_PF_GenesysRoboticHand_Galindrez-Grassi/Documentación/Medidas componentes/Led.jpg

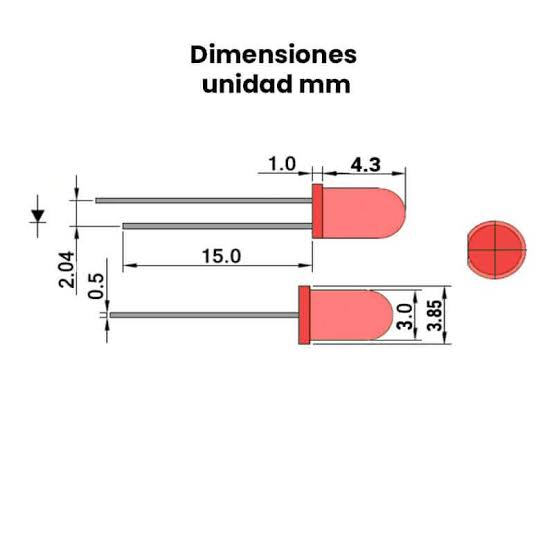
Documentación/Medidas componentes/Led.jpg
