ThomasG-29/2026_2C_PF_GenesysRoboticHand_Galindrez-Grassi/Conexionados/esquema_fisico_wiring_mux_ads_esp32.png

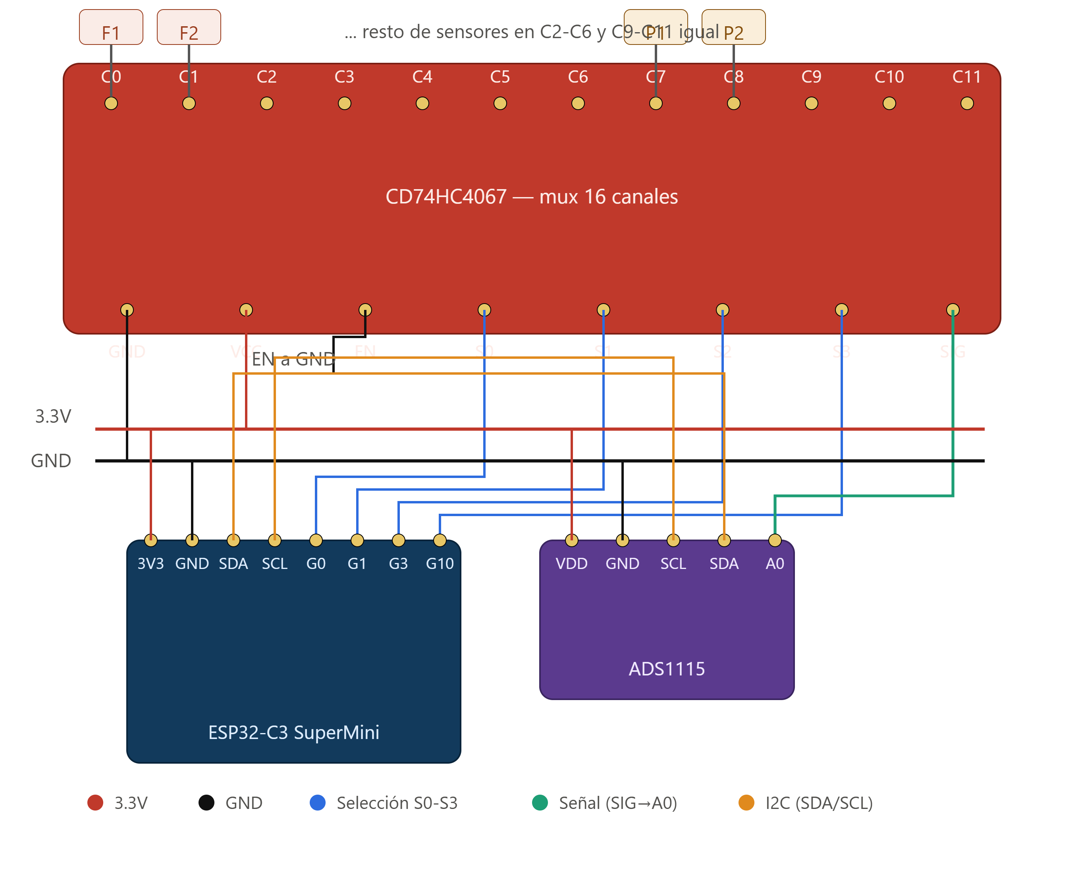
Conexionados/esquema_fisico_wiring_mux_ads_esp32.png
