ThomasG-29/2026_2C_PF_GenesysRoboticHand_Galindrez-Grassi/(list of files, drawings)

Other design files:
Conexionados/Circuito_guante - v2.fzz
Conexionados/Circuito_guante.fzz
Conexionados/Circuito_mano_robot.fzz
Conexionados/FRITZING/Untitled Sketch.fzz
