ThomasG-29/2026_2C_PF_GenesysRoboticHand_Galindrez-Grassi/(commit log)

2026-08-25 Primera versión de CADs y documentació
2026-10-12 Sincronizar solo la carpeta Códigos con GitHub
    - .gitignore: solo se versiona Códigos (CAD y documentación quedan en OneDrive)
    - Configuración de VS Code/PlatformIO de la prueba ESP-NOW
2026-10-12 Prueba de sincronización con GitHub
2026-10-12 Prueba 2 de sincronización en GitHub
2026-10-12 Organización de codigos en VS code
2026-10-12 Pruebas funcionales de comunicacion ESP-NOW
2026-10-12 Sincronización de carpetas con mismo nombre
2026-10-12 Prueba de funcionamiento de Servos y sensores con ESP-NOW
2026-10-14 Calibración servo del flex 7
2026-10-17 Calibracion sensores y agregado de home
2026-10-19 Actualización de conexionados
2026-10-20 calibracion de servos y pruebas funcionales
2026-10-26 Calibracion de potenciometros
2026-10-31 Agregado de flex lateral para muñeca para compensacion
2026-11-04 Calibracion de sensores
2026-11-11 Imágenes de conexionados
2026-11-11 Actualización circuito de la mano
2026-11-11 Imagen actualizada circuito de la mano
2026-11-11 Actualización imagen circuito mano robot
2026-11-11 Actualización de documentacion
2026-11-11 Actualización lista de materiales
2026-11-11 Agragado protección de voltaje en boton home
2026-11-11 Pruebas y correcciones de conexionados
